power2000/upc/3780-schem (1).pdf

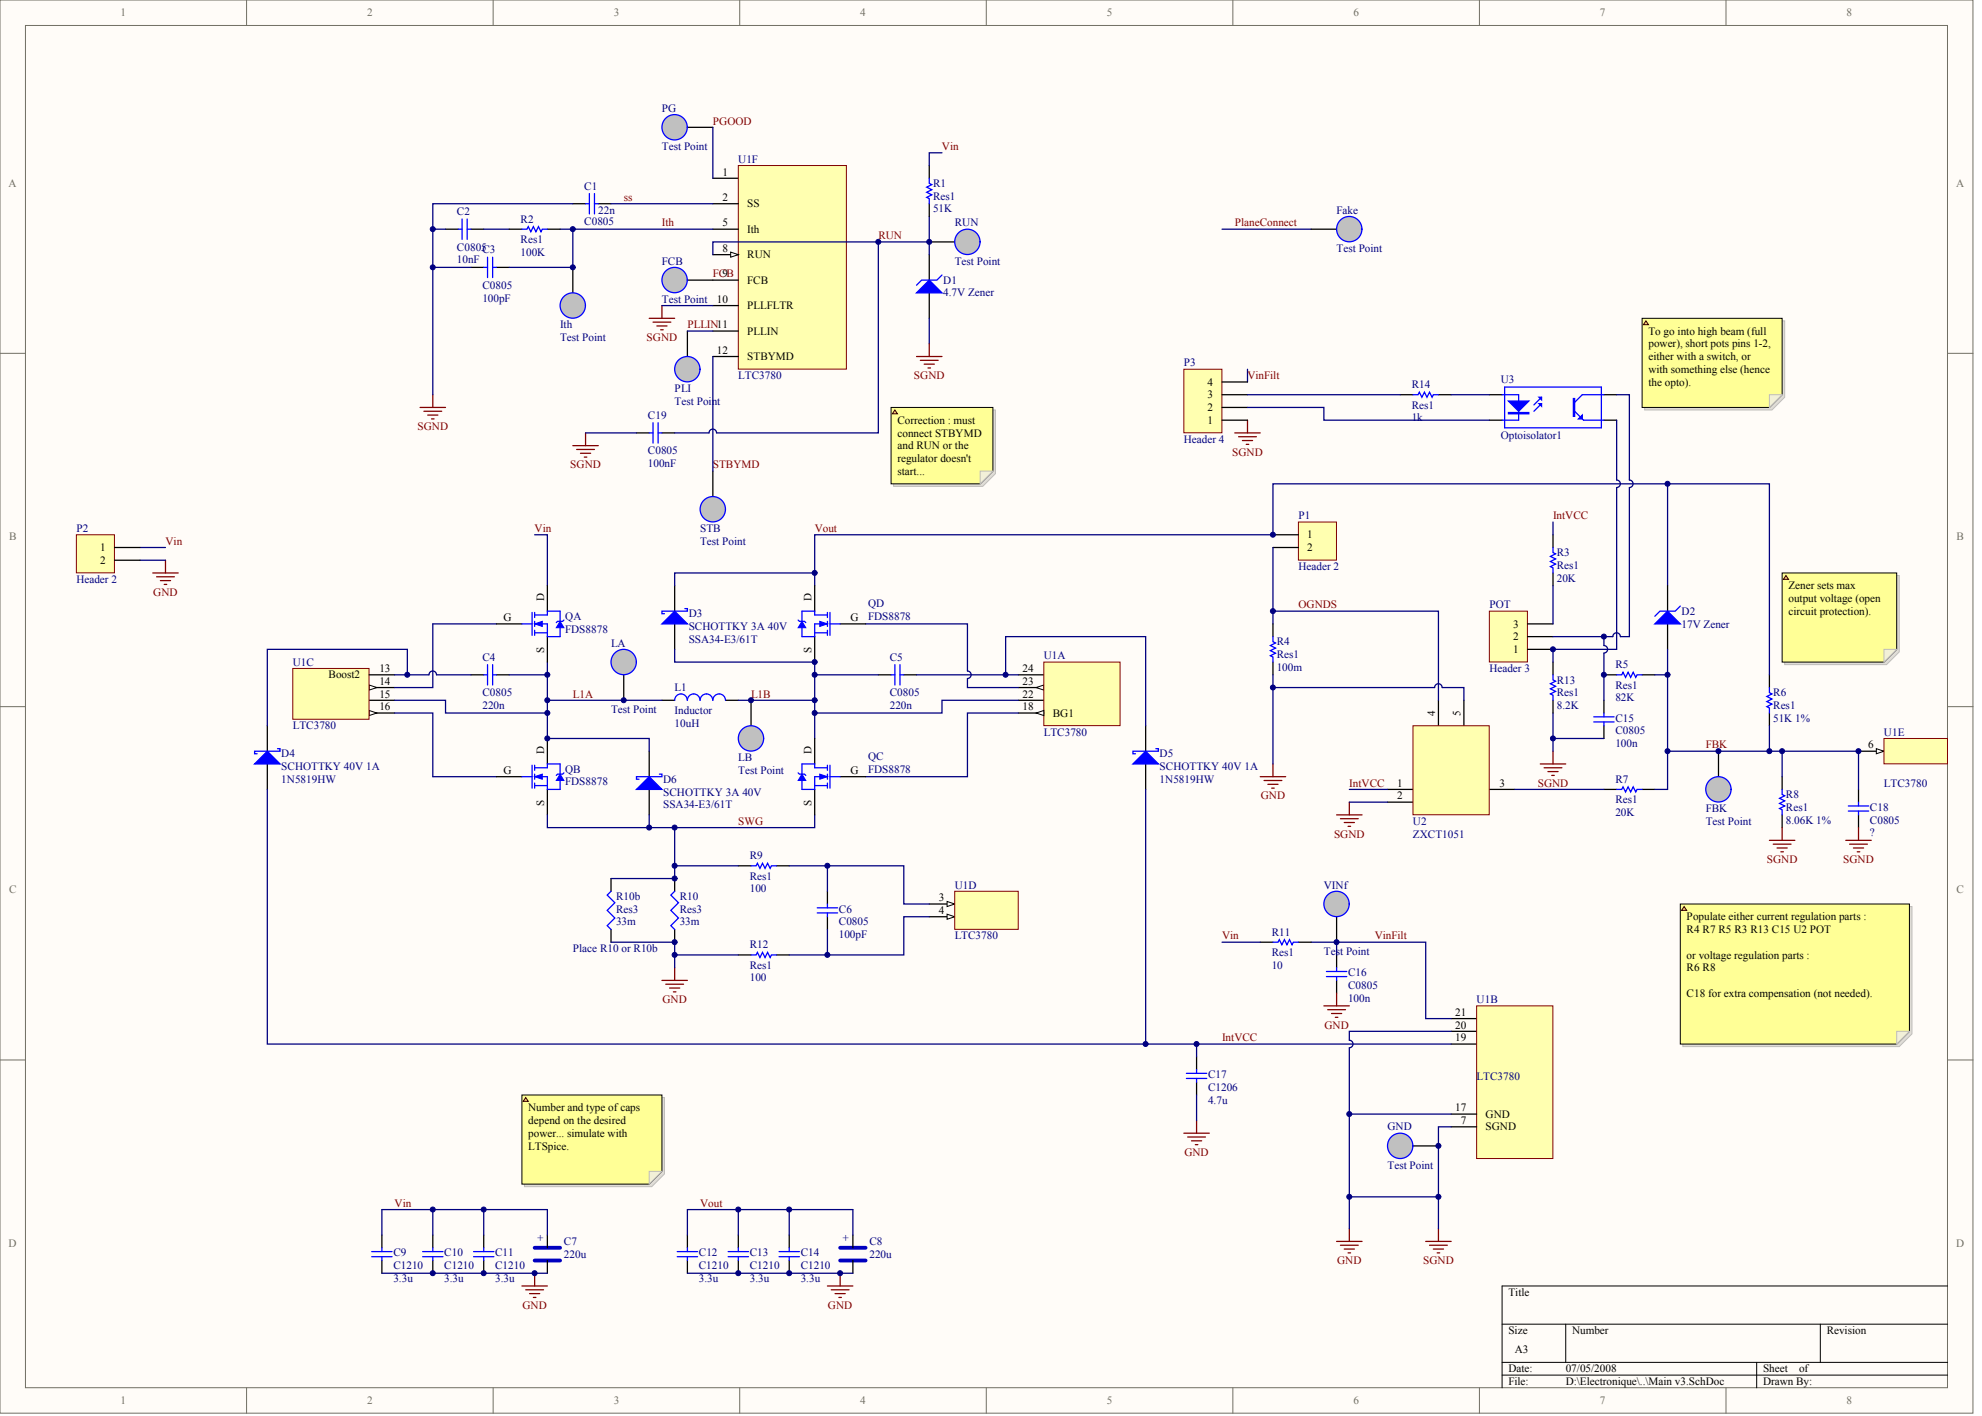
[picture p12: page 1]

C2 | C0805 Ith N0ITH 5 P0U1F05

C0805 | | Res1 100K

To go into high beam (full
power), short pots pins 1-2,
either with a switch, or
with something else (hence
the opto).

Correction : must
connect STBYMD
and RUN or the
regulator doesn't
start...

Populate either current regulation parts :
R4 R7 R5 R3 R13 C15 U2 POT

or voltage regulation parts :

C18 for extra compensation (not needed).

Number and type of caps
depend on the desired
power... simulate with LTSpice.
