power2000/upc/(commit log)

2011-09-07 added mini-buck/boost for uC
2011-09-07 controller/display buck/boot converter
2011-09-09 started layouting 5V buckboost, some eagle lbrs
    [logic.sch]
